Sensirion/smartgadget-sht4x-hardware/README.md

# smartgadget-sht4x-hardware

Hardware files for the SHT4x SmartGadget reference design.
