Sensirion/smartgadget-sht4x-hardware/2254923_Gordo2_SHT4x_V3_ASSEMBLY_AV1/2254923_Gordo2_SHT4x_V3_BOM_AV1.xlsx

Bill of Material |  | Gordo2_SHT4x |  | V | 3
File Name: | Gordo2_SHT4x.SchDoc |  |  |  | Report Date: | 09.12.2020
PCB No.: | 2254923
Variant: | AV1
Designator | Comment | Footprint | Remarks | Quantity | Manufacturer 1 | Manufacturer Part Number 1 | Manufacturer 2 | Manufacturer Part Number 2
Bat1 | 3V | BAT_BAT-HLD-001-THM |  | 1 | Linx | BAT-HLD-001-THM
C1, C2, C3, C4, C5, C6, C7, C8, C23 | 100n | C_0402 | 10V/X7R | 9 | supplier suggested | supplier suggested
C10, C11, C12, C13 | no electrical function (e.g. 1uF) | C_0805 | height = 1.25mm ±0.2mm | 4 | supplier suggested | supplier suggested
C14, C15, C16, C17 | 22u | C_0603 | 6V3/X5R | 4 | supplier suggested | supplier suggested
IC1 | MC9S08LL8CGT | QFN50P700X700X80_HS-49N |  | 1 | NXP Freescale | MC9S08LL8CGT
IC2 | BVMCN5103-CEAA-BK | BVMCN5103_Small | 16kB RAM | 1 | Braveridge | BVMCN5103-CEAA-BK
LCD1 | LCD_1209061_A2 | LCD_1209061 |  | 1 | Orient Display Ltd. | LCD_1209061_A2
Q1 | ABS07-32.768KHZ-T | XTAL_ABS07 |  | 1 | Abracon | ABS07-32.768KHZ-T
R4, R6 | 10k | R_0402 | 1% | 2 | supplier suggested | supplier suggested
Sen1 | SHT40-AD1B | SHT4x-xD1 |  | 1 | Sensirion AG | SHT40-AD1B-R2
SW1 | EVQ-Q2P02W | SW_EVQQ2P02W |  | 1 | Panasonic | EVQ-Q2P02W
 |  |  |  | 26
Approved |  | Notes
