Sensirion/smartgadget-sht4x-hardware/SHT4x_SmartGadget_3D.step

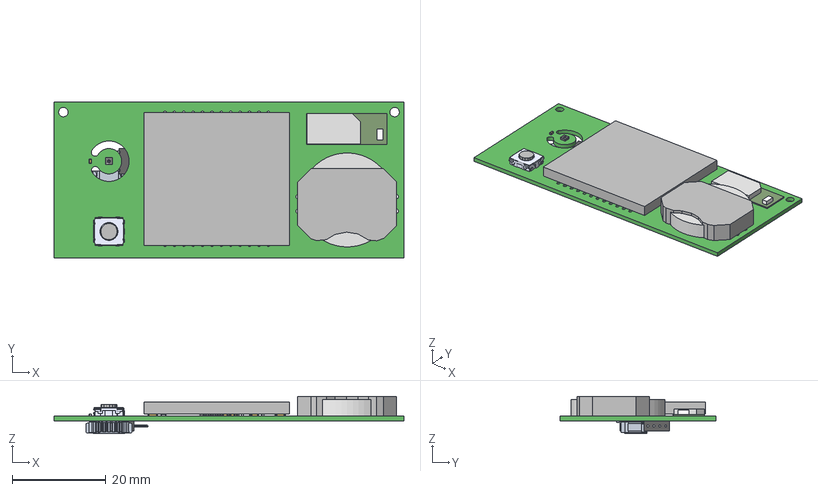
[picture p1: CAD file, 2023-02-22]
SHT4x_SmartGadget_3D.step
74.5 x 33.1 x 7.91 mm
140509-01_Publikationsmodell_SHT4x
pcb_connector_850-10-004-40-251101
Extruded x 6
Open_CASCADE_STEP_translator_6.8_52.1.1 x 4
Open_CASCADE_STEP_translator_6.8_52.1.2 x 4
Open_CASCADE_STEP_translator_6.8_52.2.1 x 4
Open_CASCADE_STEP_translator_6.8_50.1.1 x 9
Open_CASCADE_STEP_translator_6.8_50.1.2 x 9
Open_CASCADE_STEP_translator_6.8_50.2.1 x 9
Open_CASCADE_STEP_translator_6.8_10.1
Open_CASCADE_STEP_translator_6.8_10.2.1
Thermal_Shape
Open_CASCADE_STEP_translator_6.8_10.4.1 x 48
ABS07
Mid_Body x 2
Open_CASCADE_STEP_translator_6.8_62.2.1 x 4
Mark x 2
User_Library-EVQQ2-DHMSW2-02W
ssfw04r_1_3st_lf
Open_CASCADE_STEP_translator_6.8_70.1.1 x 6
Open_CASCADE_STEP_translator_6.8_70.1.2 x 6
Open_CASCADE_STEP_translator_6.8_70.2.1 x 6
