Sensirion/smartgadget-sht4x-hardware/2254923_Gordo2_SHT4x_V3_Schematic_AV1.PDF

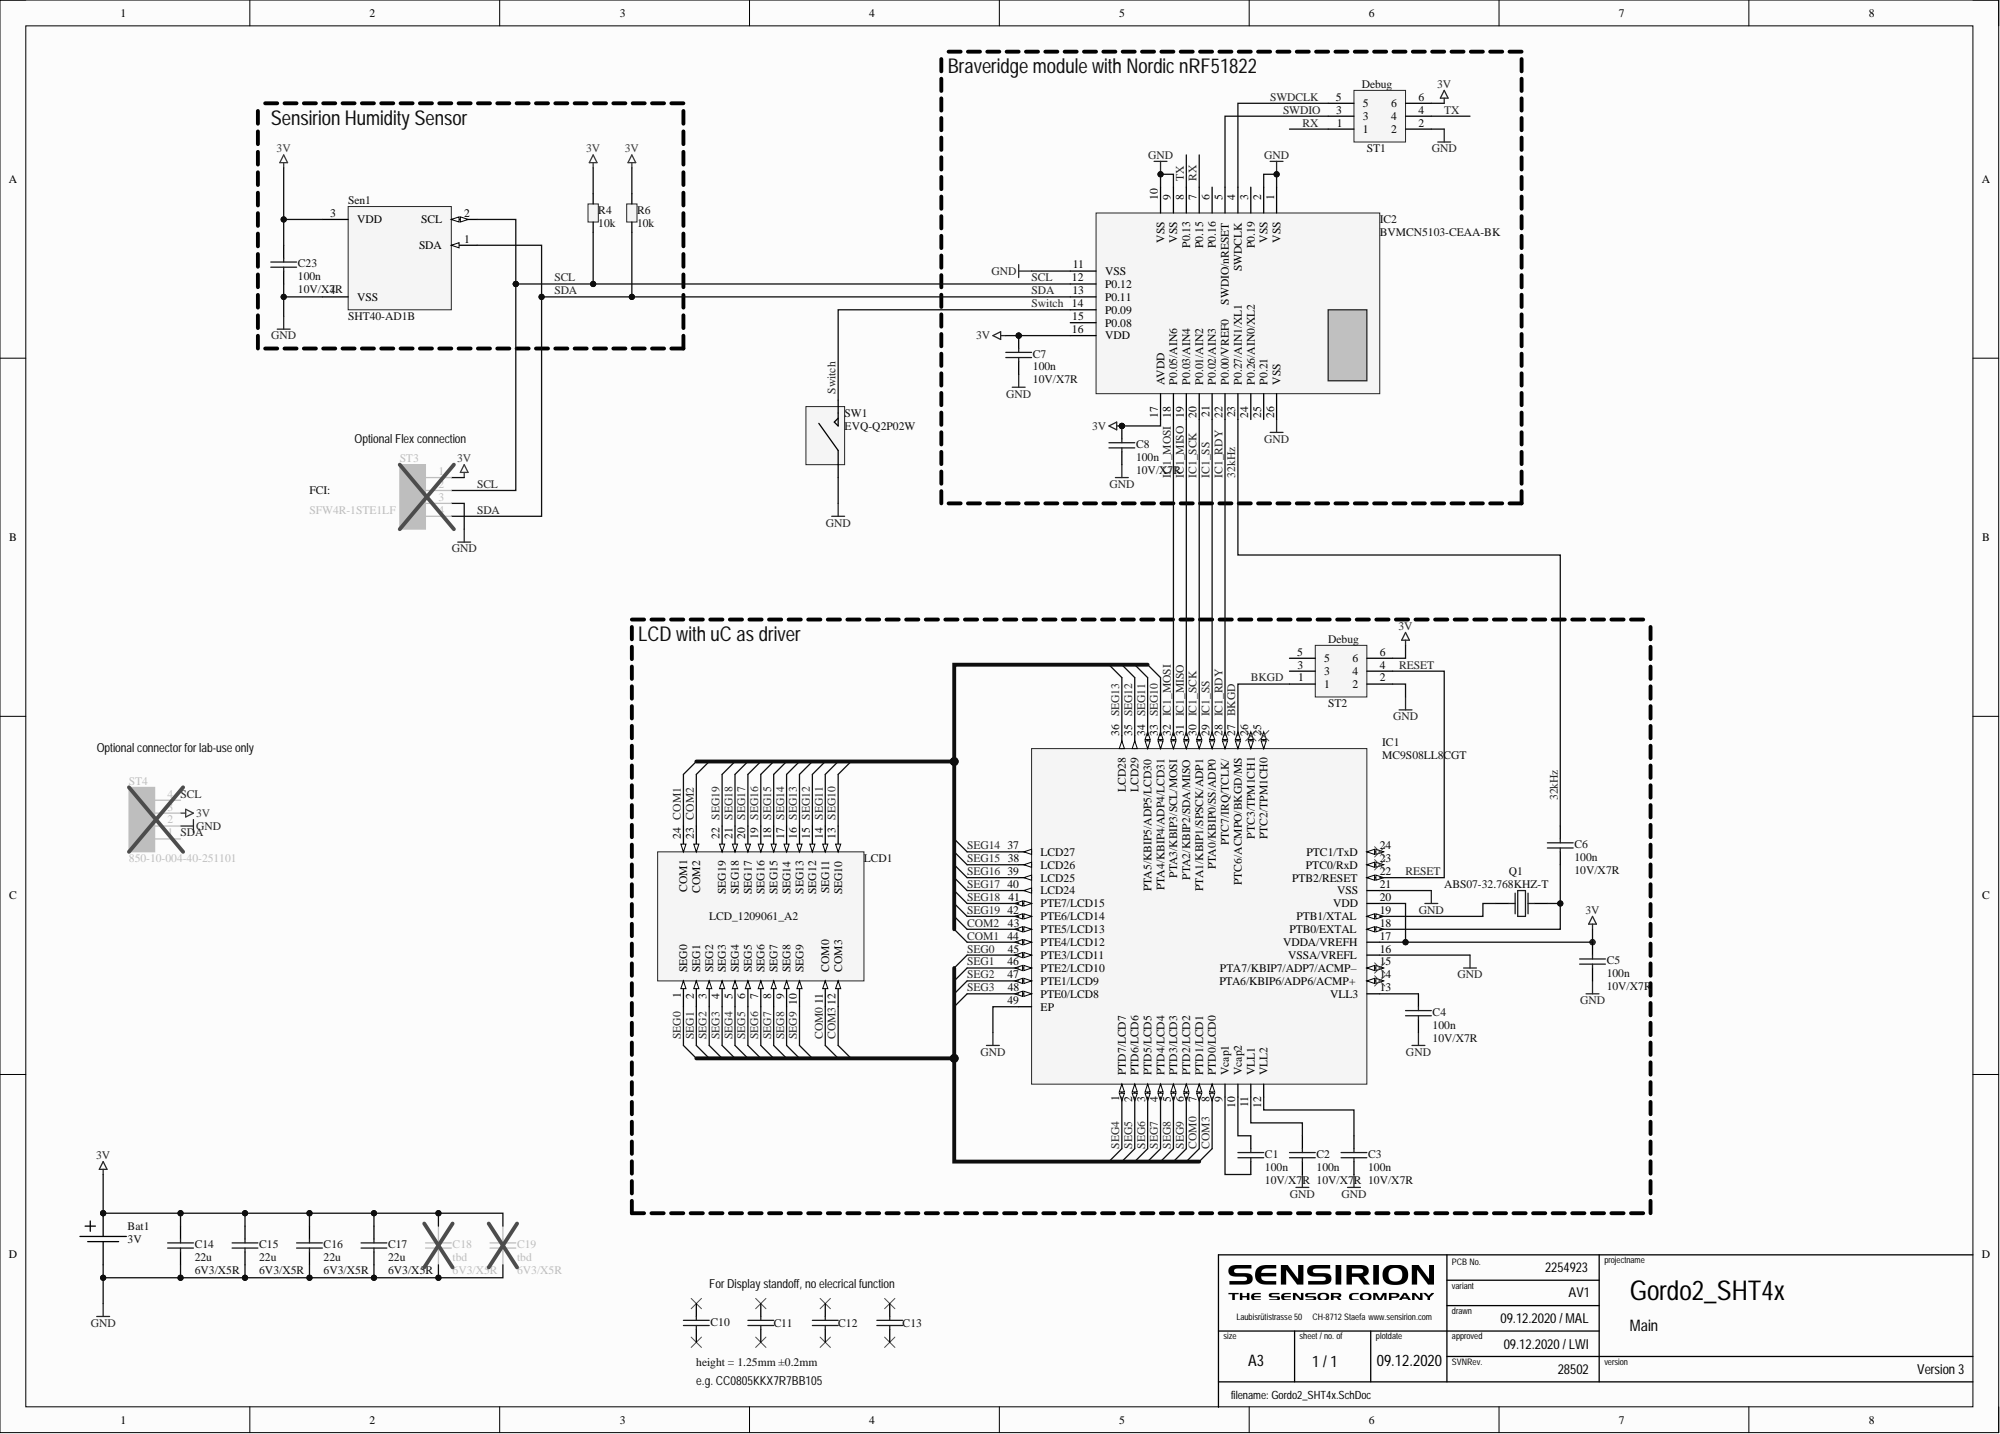
[picture p2: page 1]

Braveridge module with Nordic nRF51822

SWDIO | | 1 1 3 3 5 5

VSS 1 VSS 2 P0.19 3 SWDCLK 4 SWDIO/nRESET 5 P0.16 6 P0.15 7 P0.13 8 VSS 9 VSS 10

SCL
SDA | SDA | | P0.11 13

3V SCL | | | Switch | P0.09 14

LCD with uC as driver

MC9S08LL8CGT Optional connector for lab-use only

For Display standoff, no elecrical function

Laubisrütistrasse 50 CH-8712 Staefa www.sensirion.com
