Sensirion/smartgadget-sht4x-hardware/2254923_Gordo2_SHT4x_V3_ASSEMBLY_AV1/2254923_Gordo2_SHT4x_V3_Assembly_AV1.PDF

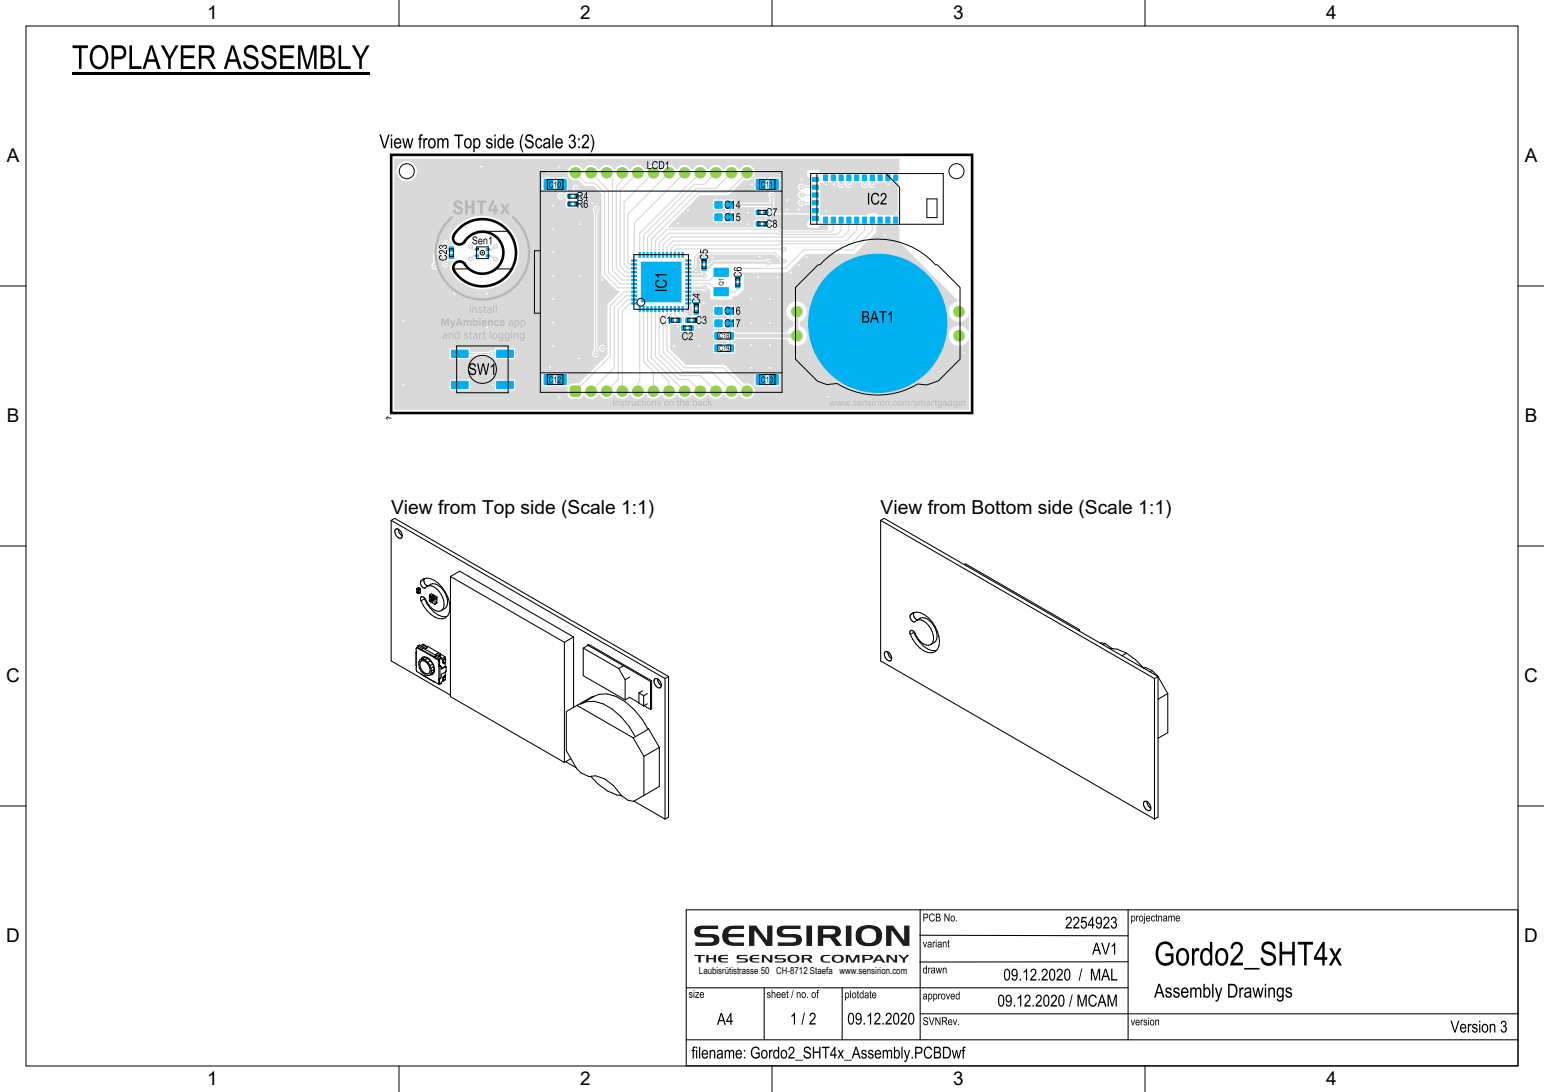
[picture p3: page 1]

Laubisrütistrasse 50 CH-8712 Staefa www.sensirion.com

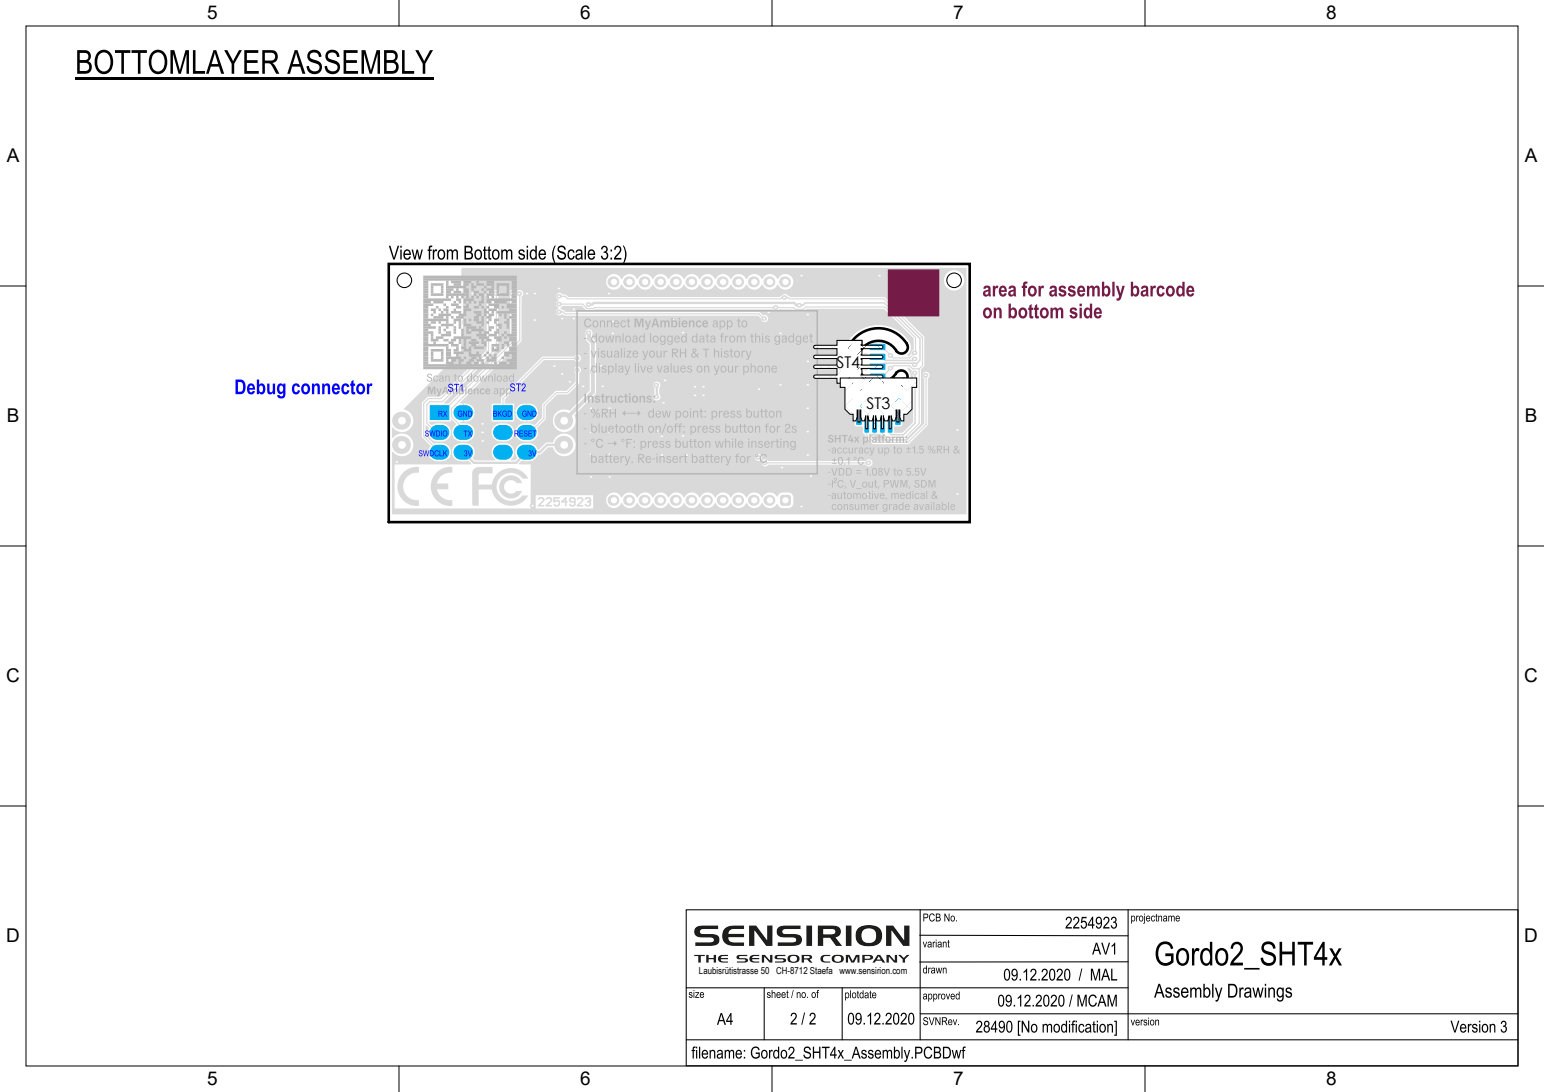
[picture p4: page 2]

Laubisrütistrasse 50 CH-8712 Staefa www.sensirion.com
