Sensirion/smartgadget-sht4x-hardware/(threads)

Thread 2 (2022-09-05):

Small design error in the circuit diagram

Michael33X, 2022-09-05:
First of all, thanks for the great board, one of the best environmental meters I know.

**FYI:** I have extended the SHT31 firmware with a one-button menu (yes, that works) and additional functions, such as various smoothing filters, °F/°C switching, powersave on/off and more. I will release this extension as a fork in the near future.

In this context, I discovered a small error in the hardware design. The SHT3X board is also affected because the design is almost identical. Apparently the circuit even works. Nevertheless, in my opinion, there is a design flaw.

**What is it about?** It is about the clock sharing of the two MCUs.

IC1 has a crystal oscillator (32 kHz) which supplies IC2. Normally the oscillator output of IC1 would be connected to the clock input of IC2 to realize clock sharing. This was not done here in the circuit. Instead the clock input of IC1 (EXTAL pin 18) was connected to the clock input of IC2 (XL1 pin23) via a capacitor - see picture below.

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

The double load of the crystal (high impedance) affects the oscillation condition, changes the oscillation frequency (which does not bother here), but could possibly cause the oscillator not to oscillate. It is better to switch the oscillator output (IC1 XTAL pin19) to the clock input (IC2 XL1 pin 23) - see picture below.

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

You will say thousands of sold boards prove the circuit works. Nevertheless, this is a design flaw. I recommend changing this in a future revision. After all, this is a reference design.

**By the way:** if you are planning a revision, I suggest to design the PCB in a way that it can be easily put into a case. Currently, the button and the sensor are arranged in such a way that they would disappear into a housing when installed in it. The sensor and the button should be flush with a front panel.

Perhaps it is also an idea that you manufacture and supply a suitable housing **yourself.**

psachs, 2022-10-14:
thank you very much for the detailed report and the great input. I will forward this issue to the responsible person and check what we can do to improve our design for future releases

Michael33X, 2022-11-17:
Thank you very much for your reply,

by the way, I think that the documentation of a reference design should include the source code. For the previous model "SHT31 Smart Gadget" you have published the source code on github, but not for the SHT4x Smart Gadget. Why? Both boards are identical except for the sensor. I could adapt the SHT31 firmware to the SHT4x sensor myself. It would be easier if you would publish the source code. I can't see that there could be any secrets in it.

Translated with www.DeepL.com/Translator (free version)

Michael33X, 2022-11-17:
Thank you very much for your reply,

by the way, I think that the documentation of a reference design should include the source code.

For the previous model "SHT31 Smart Gadget" you have published the source code on github, but not for the SHT4x Smart Gadget. Why?
Both boards are identical except for the sensor. I could adapt the SHT31 firmware to the SHT4x sensor myself. It would be easier if you would publish the source code. I can't see that there could be any secrets in it.

psachs, 2022-11-28:
Sorry for the late answer.

The current SHT4x firmware source code was re-written and includes some internal software packages. Therefore, we can't release the SHT4x firmware as open source.
However, we plan to release the next firmware version as open source again in a couple month. I am very sorry for the inconvenience.

Thread 3 (2023-02-18):

3D model

SengerM, 2023-02-18:
Hello, thanks for making this available. Could you upload the 3D model of the board with all the components included? I have one of these and want to 3D print a custom case. I know about [this one](https://github.com/Sensirion/smartgadget-sht4x-housing), but need to make a different design. Any standard/open format should work, e.g. STEP or STL.

Thanks!

qfisch, 2023-02-20:
Hello @SengerM ,
Thank you for the suggestion.
Your request has been heard and we will add a 3D model to this repository shortly.
Please let us know if we can help further.
Quentin

qfisch, 2023-02-22:
It has been added to the repository.
Have a nice day :smiley:

Closed 2023-02-22.
